adamgreen/Ferdinand16/photos/20160603-01.png

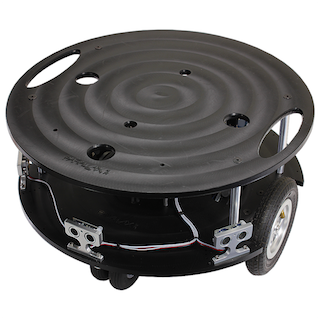
photos/20160603-01.png
