adamgreen/Ferdinand16/photos/20160730-01.jpg

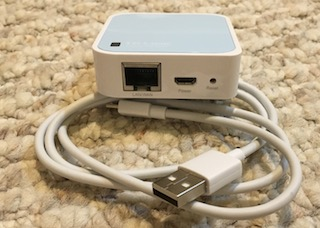
photos/20160730-01.jpg
