adamgreen/Ferdinand16/docs/28996-Arlo-Power-Dist-Brd-Schematic-Rev-B.pdf

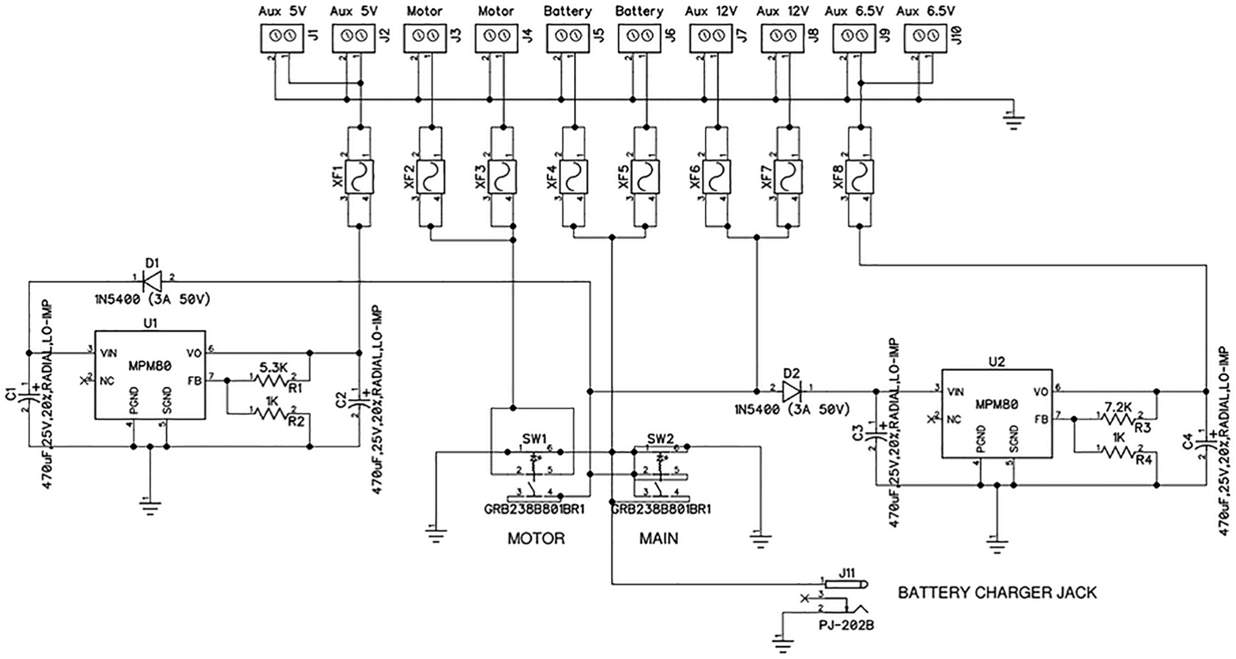
[picture p3: figure]
