adamgreen/Ferdinand16/docs/June2nd_gyro.numbers/preview-web.jpg

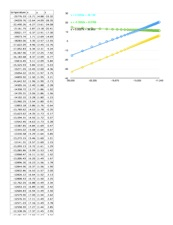
docs/June2nd_gyro.numbers/preview-web.jpg
