adamgreen/Ferdinand16/photos/20160603-02.jpg

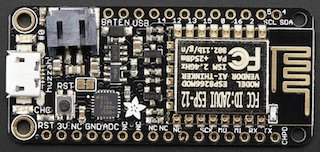
photos/20160603-02.jpg
