adamgreen/Ferdinand16/photos/20160603-03.png

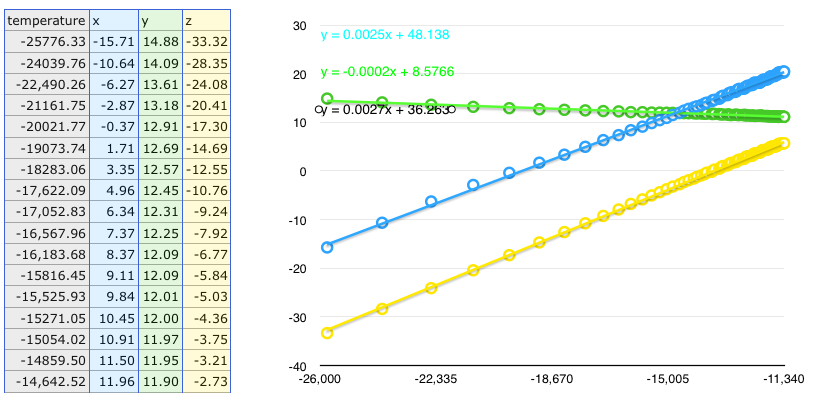
photos/20160603-03.png
