adamgreen/Ferdinand16/photos/20160603-04.jpg

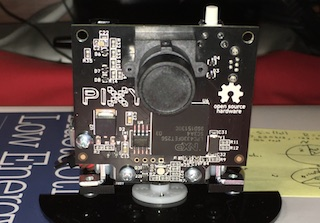
photos/20160603-04.jpg
