adamgreen/Ferdinand16/photos/20160603-05.jpg

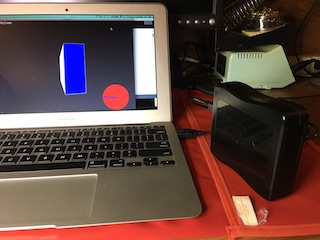
photos/20160603-05.jpg
