adamgreen/Ferdinand16/photos/20160603-06.jpg

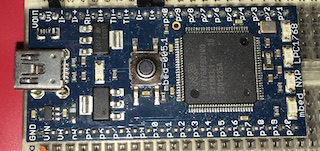
photos/20160603-06.jpg
