adamgreen/Ferdinand16/photos/20160603-07.png

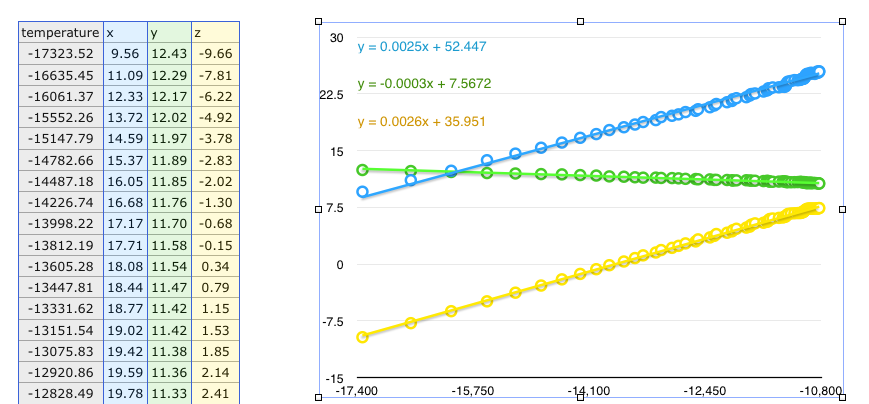
photos/20160603-07.png
