adamgreen/Ferdinand16/photos/20160606-01.jpg

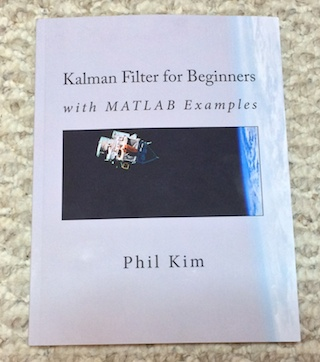
photos/20160606-01.jpg
