adamgreen/Ferdinand16/photos/20160606-02.jpg

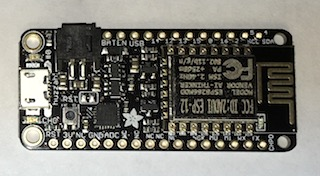
photos/20160606-02.jpg
