adamgreen/Ferdinand16/photos/20160607-01.jpg

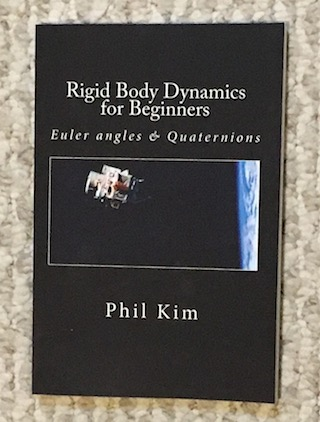
photos/20160607-01.jpg
