adamgreen/Ferdinand16/photos/20160609-01.jpg

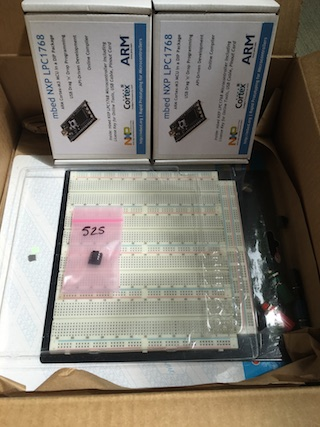
photos/20160609-01.jpg
