adamgreen/Ferdinand16/photos/20160612-01.jpg

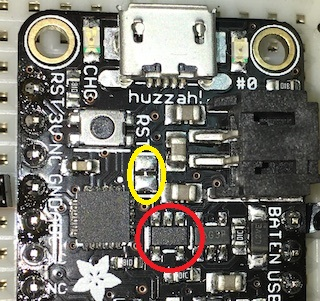
photos/20160612-01.jpg
