adamgreen/Ferdinand16/photos/20160612-02.jpg

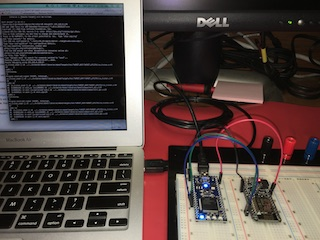
photos/20160612-02.jpg
