adamgreen/Ferdinand16/photos/20160619-01.jpg

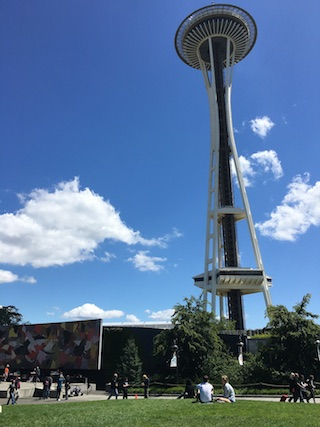
photos/20160619-01.jpg
