adamgreen/Ferdinand16/photos/20160619-02.jpg

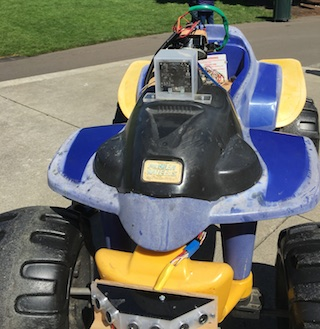
photos/20160619-02.jpg
