adamgreen/Ferdinand16/photos/20160619-03.jpg

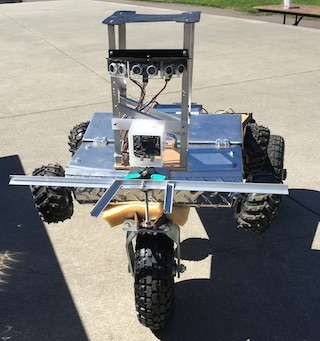
photos/20160619-03.jpg
