adamgreen/Ferdinand16/photos/20160619-04.jpg

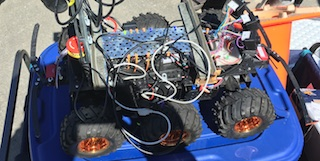
photos/20160619-04.jpg
