adamgreen/Ferdinand16/photos/20160619-05.jpg

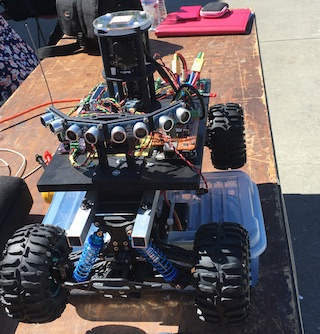
photos/20160619-05.jpg
