adamgreen/Ferdinand16/photos/20160620-01.jpg

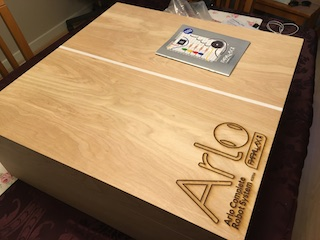
photos/20160620-01.jpg
