adamgreen/Ferdinand16/photos/20160620-02.jpg

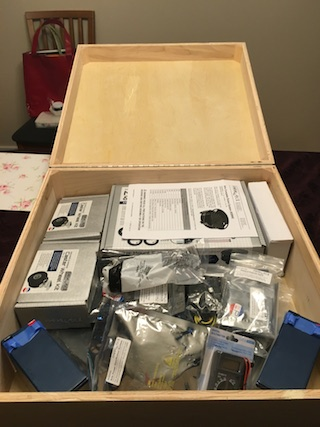
photos/20160620-02.jpg
