adamgreen/Ferdinand16/photos/20160620-03.jpg

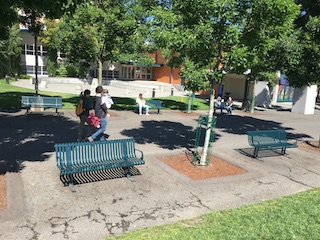
photos/20160620-03.jpg
