adamgreen/Ferdinand16/photos/20160624-01.jpg

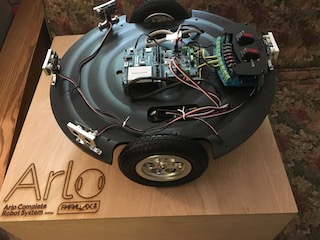
photos/20160624-01.jpg
