adamgreen/Ferdinand16/photos/20160720-01.jpg

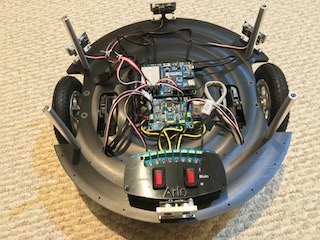
photos/20160720-01.jpg
