adamgreen/Ferdinand16/photos/20160720-02.jpg

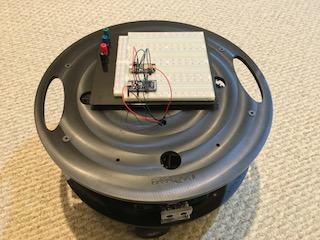
photos/20160720-02.jpg
