adamgreen/Ferdinand16/photos/20160722-01.jpg

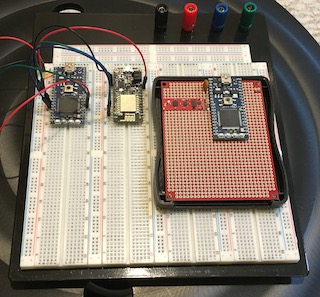
photos/20160722-01.jpg
