adamgreen/Ferdinand16/photos/20160722-02.jpg

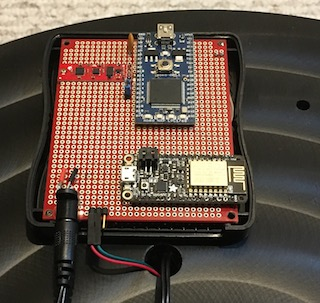
photos/20160722-02.jpg
