adamgreen/Ferdinand16/photos/20160723-01.png

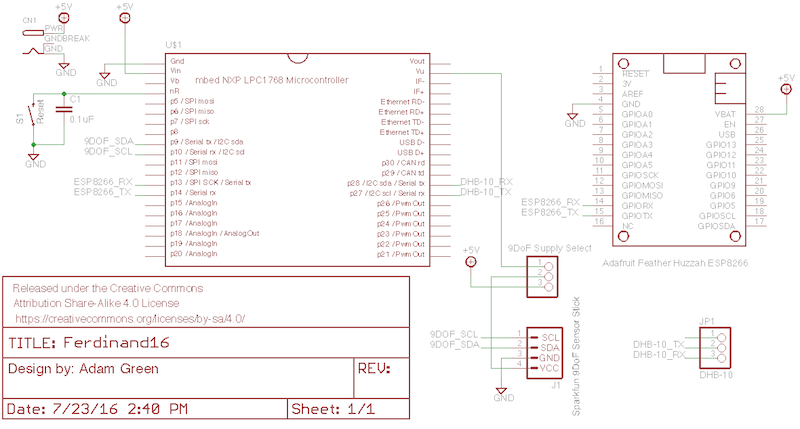
photos/20160723-01.png
