adamgreen/Ferdinand16/photos/20160723-02.png

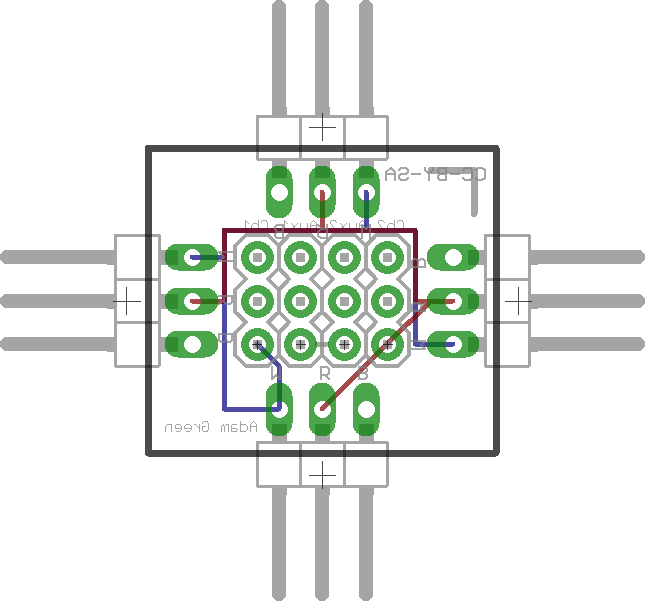
photos/20160723-02.png
