adamgreen/Ferdinand16/photos/20160728-01.jpg

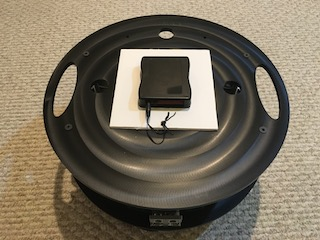
photos/20160728-01.jpg
