adamgreen/Ferdinand16/photos/20160929-01.jpg

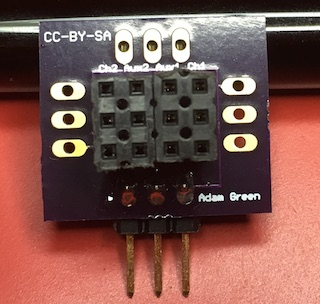
photos/20160929-01.jpg
