adamgreen/Ferdinand16/photos/20160929-02.jpg

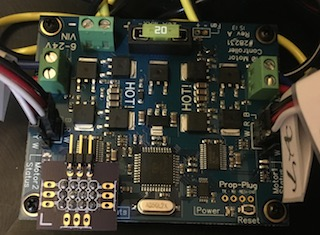
photos/20160929-02.jpg
