adamgreen/Ferdinand16/photos/20160929-03.jpg

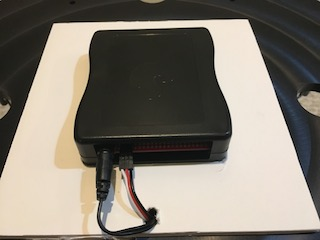
photos/20160929-03.jpg
