adamgreen/Ferdinand16/photos/20161004-01.jpg

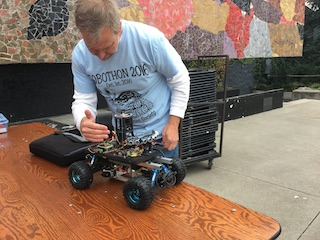
photos/20161004-01.jpg
