adamgreen/Ferdinand16/photos/20161004-04.gif

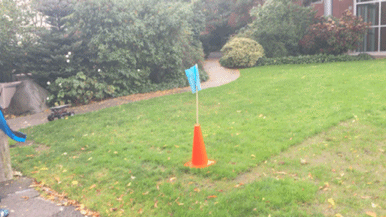
photos/20161004-04.gif
