adamgreen/Ferdinand16/docs/9DoF-Stick-v13.pdf

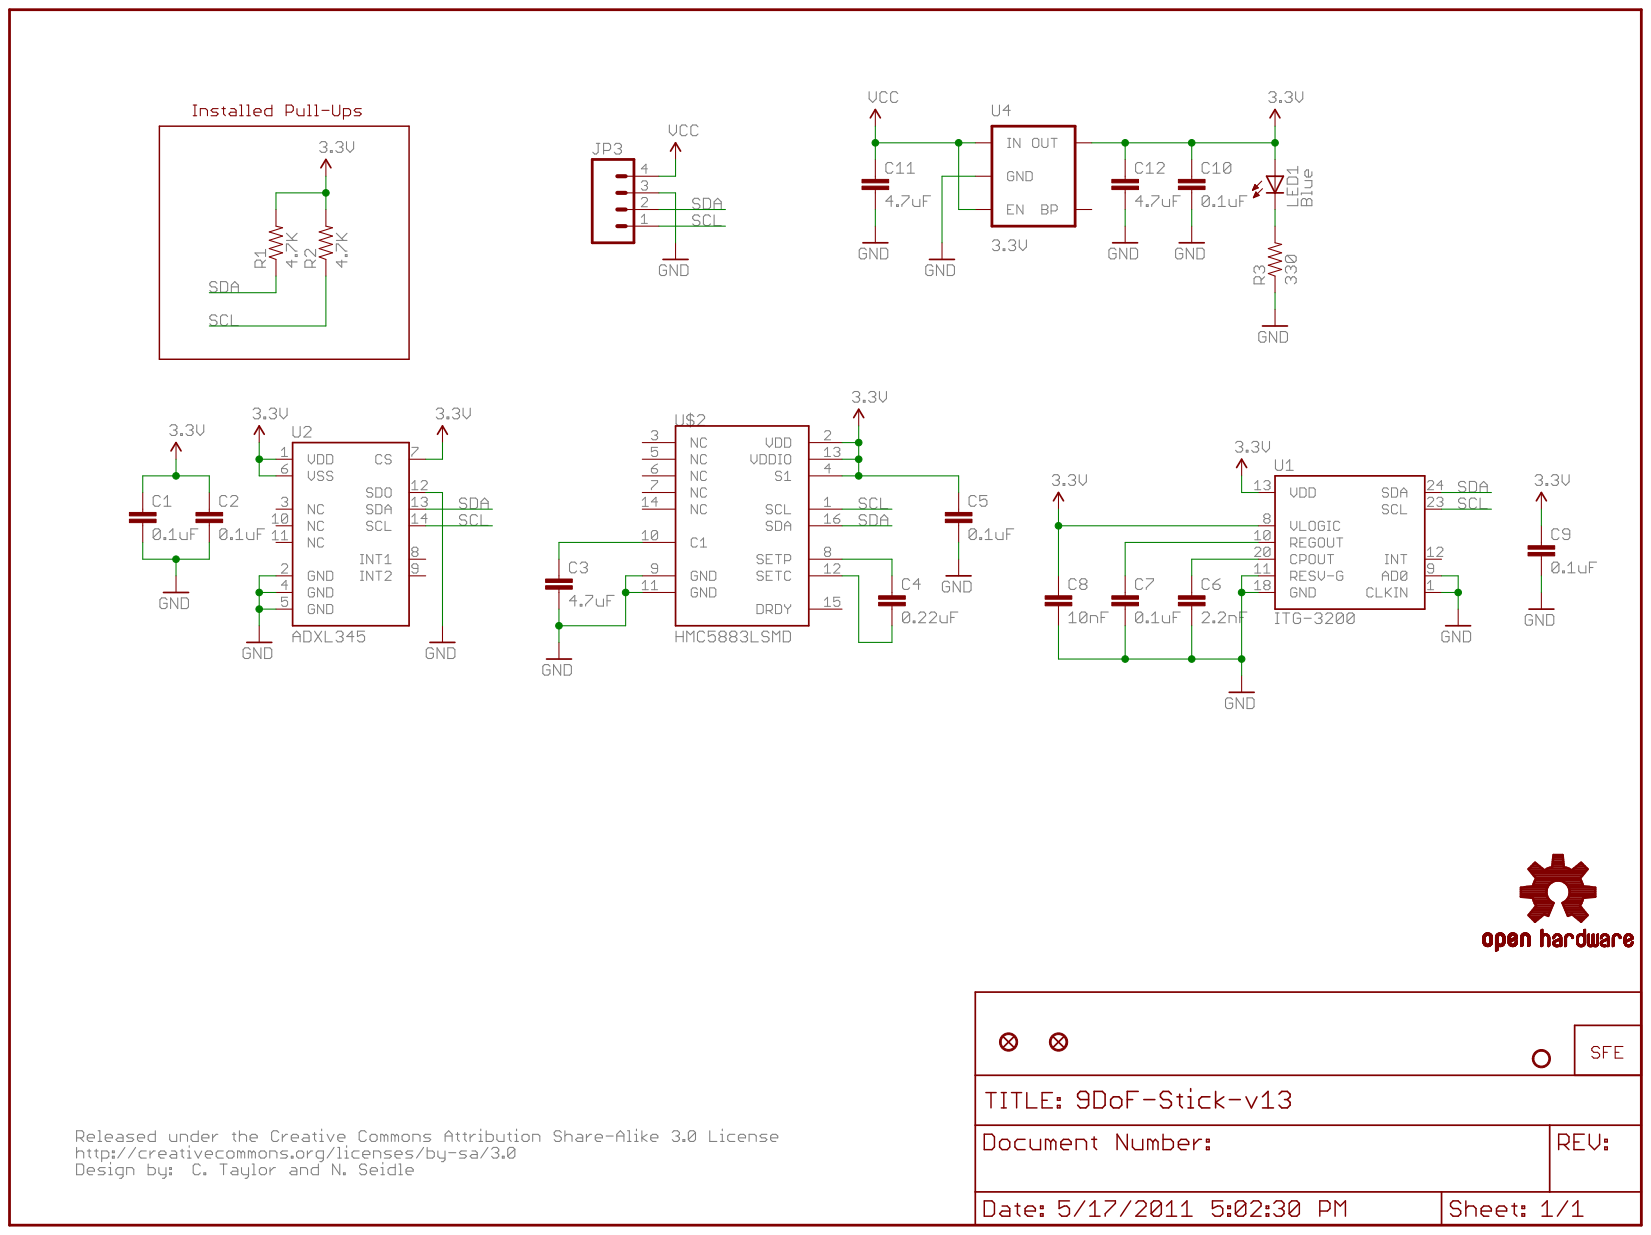
[picture p39: page 1]
