adamgreen/Ferdinand16/eagle/DHB-10_Serial_Converter.brd

## EAGLE design eagle/DHB-10_Serial_Converter.brd (2016-07-24)

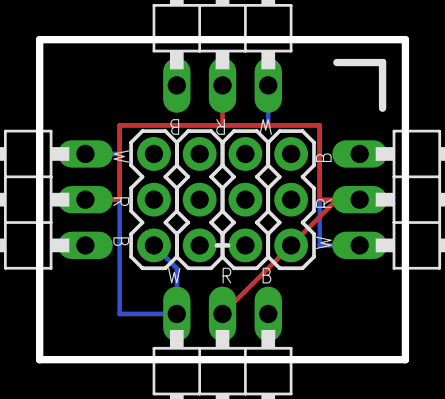
[picture p40: board DHB-10_Serial_Converter.brd from above]

Board: 2 copper layers, 20.3 x 17.8 mm, 8 parts (0 on the bottom side), 2 nets.

Parts:
E$1, E$6, E$7, E$8: 1X03/90
E$2, E$3, E$4, E$5: 1X03

Connections:
S$1: E$1.3, E$2.1, E$6.3, E$7.3, E$8.3
S$2: E$1.2, E$5.1, E$6.2, E$7.2, E$8.2
