adamgreen/Ferdinand16/firmware/robot/PID.h

/*  Copyright (C) 2015  Adam Green (https://github.com/adamgreen)

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
    This program is distributed in the hope that it will be useful,
    but WITHOUT ANY WARRANTY; without even the implied warranty of
    MERCHANTABILITY or FITNESS FOR A PARTICULAR PURPOSE.  See the
    GNU General Public License for more details.
*/
/* Class to abstract PID (proportional, integral, derivative) algorithm.
   It is inspired by Brett Beauregard's Arduino PID Library (https://github.com/br3ttb/Arduino-PID-Library/) and
   the PID e-book available on controlguru (http://www.controlguru.com).

   NOTE: compute() method has been modifed to expect angles in radians for the setpoint and process values such that
         the error needs to be constrained to fall between -PI and PI radians.
*/
#ifndef PID_H_
#define PID_H_

#include <assert.h>
#include <mbed.h>
#include <Sparkfun9DoFSensorStick.h>

class PID
{
public:
    PID(float Kc, float Ti, float Td, float controlOutputBias, float controlMin, float controlMax, float sampleTime)
    {
        m_sampleTime = sampleTime;
        setTuningParameters(Kc, Ti, Td);
        m_isAuto = false;
        m_controlOutputBias = controlOutputBias;
        m_controlMin = controlMin;
        m_controlMax = controlMax;
        m_controlOutput = controlOutputBias;
        m_setPoint = 0.0f;
        m_integral = 0.0f;
        m_processLast = 0.0f;
    }

    void updateSetPoint(float setPoint)
    {
        m_setPoint = setPoint;
    }

    float getSetPoint()
    {
        return m_setPoint;
    }

    float compute(float processCurrent)
    {
        if (m_isAuto)
        {
            float error = Sparkfun9DoFSensorStick::constrainAngle(m_setPoint - processCurrent);
            float processDelta = processCurrent - m_processLast;
            float integral = m_integral + m_Ki * error;
            float controlOutput;

            controlOutput = m_controlOutputBias + m_Kp * error + integral - m_Kd * processDelta;
            if (controlOutput < m_controlMin)
            {
                if (m_usesIntegral)
                    integral += (m_controlMin - controlOutput);
                controlOutput = m_controlMin;
            }
            else if (controlOutput > m_controlMax)
            {
                if (m_usesIntegral)
                    integral -= (controlOutput - m_controlMax);
                controlOutput = m_controlMax;
            }
            m_integral = integral;
            m_controlOutput = controlOutput;
        }

        m_processLast = processCurrent;
        return m_controlOutput;
    }

    float getControlOutput()
    {
        return m_controlOutput;
    }

    void setOutputManually(float controlOutput)
    {
        if (controlOutput < m_controlMin)
            controlOutput = m_controlMin;
        if (controlOutput > m_controlMax)
            controlOutput = m_controlMax;
        m_isAuto = false;
        m_controlOutput = controlOutput;
    }

    void enableAutomaticMode()
    {
        if (m_isAuto)
            return;
        m_controlOutputBias = m_controlOutput;
        m_setPoint = m_processLast;
        m_integral = 0.0f;
        m_isAuto = true;
    }

    void setTuningParameters(float Kc, float Ti, float Td)
    {
        assert( Ti >= 0.0f && Td >= 0.0f && sampleTime > 0.0f );
        m_Kp = Kc;
        m_Ki = (Ti == 0.0f) ? 0.0f : (Kc / Ti) * m_sampleTime;
        m_Kd = (Td == 0.0f) ? 0.0f : (Kc * Td) / m_sampleTime;
        m_usesIntegral = (Ti != 0.0f);
    }

protected:
    float   m_Kp;
    float   m_Ki;
    float   m_Kd;
    float   m_controlOutputBias;
    float   m_controlMin;
    float   m_controlMax;
    float   m_sampleTime;
    float   m_controlOutput;
    float   m_setPoint;
    float   m_integral;
    float   m_processLast;
    bool    m_isAuto;
    bool    m_usesIntegral;
};

#endif // PID_H_
