adamgreen/Ferdinand16/(commit log)

2016-06-04 Add photo
    This is the graph of the gyro zero bias versus temperature from 2014.
2016-06-04 Initial README notes
    * Ideas for Robo-Magellan 2016 robot.
    * Initial Pixy camera notes.
    * Re-calibration of roll axis rate gyro in IMU.
2016-06-04 Add gyro calibration spreadhsheet
    This spreadsheet was used to re-calculate the gyro zero bias vs.
    temperature calibration constants.
2016-06-04 Fork orientation sample from Ferdinand14
    Just copying the orientation sample over from the Ferdinand14 project.
    This orientation code uses a Kalman filter to calculate the 3D pose of
    the IMU. I plan to simplify the code to just obtain the compass heading
    and then port to run on the LPC1768 instead of on the PC.
2016-06-12 Add ESP8266 board photos
2016-06-14 Calculate yaw from quaternion directly
    Previously I was using a row from the rotation matrix (which was
    more expensively obtained from the quaternion) and I now just pull the
    yaw, pitch, and roll angles from the quaternion instead.
2016-06-17 Start porting orientation code to LPC1768
    This is the start of porting the orientation Processing sample to the
    LPC1768. It just starts with porting of the calibration code down to
    the LPC1768 whereas it could only return the raw sensor readings
    previously.
    * The calibration data is found in files/config.ini This file it built
    into a FlashFileSystem image which is then embedded into the firmware
    image as part of the makefile processing. NOTE: The makefile uses
    the fsbld and bin2h utilities to accomplish this and they only
    work on OS X.
    https://github.com/adamgreen/bb-8/tree/master/mriprog/bin2h-src
    https://github.com/adamgreen/fsbld
    * I pulled over the original LPC1768 firm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
2016-06-18 Calculate orientation quaternion from accelerometer/magnetometer
    This commit switches the firmware to returning an orientation
    quaternion based soley on the accelerometer and magnetometer data.
    Kalman filtering will be added later.
    The orientation Processing sample was modified to expect this
    4 x float quaternion instead of the 9 x float calibrated data I added
    in the previous commit. It compares this quaternion to the one
    calculated in the Processing code to verify that I didn't regress
    anything as I ported this math to the embedded device.
    [HeadingSensor.pde, main.cpp, orientation.pde]
2016-06-18 Swizzle accel/mag based on config.ini settings
    Previously the swizzling of the accelerometer and magnetometer axis was
    hardcoded. Now it is controlled by parameters in config.ini
    Additional changes include:
    * Added accelSwizzle and magSwizzle field to SensorCalibration struct
    to provide the new swizzle settings to the Sparkfun9DoFSensorStick
    class at construction time.
    * The Vector class now has a createFromSwizzledSource() static method
    which can take a source vector and swizzle its elements around to
    match the user provided settings from config.ini
    * Added a [] operator method ot Vector to expose x, y, and z values
    as [0], [1], and [2] respectively. This made the swizzling funct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
2016-06-21 Kalman filter ported to LPC1768
    This is the initial port of the Kalman filter from the Processing
    orientation.pde sample running on the PC to C++ code running on the
    LPC1768 microcontroller. The LPC1768 is currently idle for more than
    89% of the time when running this code. This is much better than I
    expected for all of that floating point math and gives me lots of
    headroom to execute my robot navigation code.
    NOTE: This ported code appears to work as expected when switching the
    orientation.pde sample into Embedded mode (by pressing the E
    key). The orientation sample does issue println()s though
    indicating that there are some differences in the PC and embedded
    calcul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
    [config.ini, main.cpp, orientation.pde]
2016-06-21 Add animated GIF of Kalman filter
2016-06-22 Kalman filter fixes
    * Make the Kalman filter reset a thread safe. Before it was possible
    for the code in main() which would trigger the Kalman filter
    to reset and the code which would prepend the "R," to the output
    would see different values of the g_resetRequested global that is
    set true in the serialRx ISR.
    * Sparkfun9DoFSensorStick::calibrate() gyroVariance & accelMagVariance
    variables shouldn't have been static or const. These qualifiers were
    left over from when the values were still hardcoded.
    * Orientation Processing sample shouldn't compare orientation
    quaternions sent back from LPC1768 until it has been placed in
    EMBEDDED mode where a synchronized filter will be trigg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
    [main.cpp, orientation.pde]
2016-06-23 PC and LPC1768 now agree on Kalman filter results
    I was normalizing the quaternion on the LPC1768 but not the PC. This is
    now fixed.
    I also fixed the code so that it only compares the embedded results
    after the reset has completed.
    Now get no differences detected when using a threshold of 1.0E-5.
    [orientation.pde]
2016-07-14 Commit some Parallax Arlo documentation
    * Documents for the DHB-10 Dual 10-Amp Motor Controller used on the
    Arlo robot platform for this Robo-Magellan bot. The LPC1768 will need
    to be interfaced to this motor controller in the near future.
    * The schematic for the power distribution board on the Arlo.
2016-07-14 Update compass/heading rendering
    I moved the code to calculate the compass heading from orientation.pde
    to HeadingSensor.pde This code was then updated to:
    * Return a heading angle of 0 when the robot is facing north.
    * Return a heading angle of PI/2 when the robot is facing east and
    an angle of -PI/2 when facing west.
    * Add configuration options to calibrate for the magnetic declination
    error at the location where the robot is being run and to account
    for how the IMU is mounted on the robot. The current settings are
    for Redmond, WA and with the IMU project box mounted such that the
    USB cable connects towards the rear of the robot.
    * The compass needle in the orientation.pde sampl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
    [HeadingSensor.pde, orientation.pde]
2016-07-15 Port heading calculation to LPC1768
    The compass heading calculation code is now running on the LPC1768 and
    has been appended to the end of the list of measurements returned to
    the PC one hundred times/second.
    I also added code to the orientation Processing sample to compare the
    heading calculated on the PC to the value calculated by the LPC1768 and
    an error is displayed to the console if they differ.
    [HeadingSensor.pde, config.ini, main.cpp, orientation.pde]
2016-07-15 Start IMU firmware up in mode compatible with old samples
    The old Ferdinand14 samples like the ones I have for performing sensor
    calibration only expect the raw sensor readings. I have modified the
    firmware running on the LPC1768 to startup in a mode which only returns
    these raw sensor measurements and only starts returning the Kalman
    calculated values after a Kalman reset command has been sent from the
    PC.
    [HeadingSensor.pde, main.cpp]
2016-07-19 Move firmware & Processing code into sub-folders
    To support more than one Processing sample and firmware image for this
    project, there are now processing/ and firmware/ parent folders. The
    multiple Processing samples can be placed under processing/ and the
    different firmware images can be placed under firmware/.
    I also added the mriprog utility for OSX under the osx/ folder. This
    utility can be used to remotely program a LPC1768 device which is
    already running firmware utilizing the MRI debug monitor.
2016-07-19 Build DmaSerial as a library
    I want to share the DmaSerial functionality between the basic heading
    firmware that I have been working on so far and the other firmware
    variants that I plan to create in the future. To facilitate this, I
    have moved the DMA code out into its own libs/DmaSerial directory. I
    also replaced DMA.h with GPDMA.h/c from my NeoPixelTree project where
    I added GPDMA channel allocation functionality. This will allow me to
    have more than a single DmaSerial object instantiated (one for logging
    and the other for the Parallax DHB-10 Dual Motor Controller.)
2016-07-20 Add simple drive sample
    This sample instructs the Arlo platform to drive ahead at a speed of
    100 encoder ticks per second and verifies that the overall distance
    travelled (in encoder ticks) has increased as expected. This test is
    run for 2 seconds and then the robot is stopped.
    The bulk of the functionality is provided by the newly added
    libs/MotorController library which knows how to talk to the Parallax
    DHB-10 Dual Motor Controller on the Arlo.
    I have also added the bash scripts that I use for remote debug/
    programming of the LPC1768 on the robot.
2016-07-20 Add photos of completed Arlo build
    With Propeller board as the brains and another with the mbed LPC1768 as
    the brains.
2016-07-23 Move orientation sensor code into libraries
    I have moved the Sparkfun9DoFSensorStick code out into its own library
    so that it can be shared by the current Heading firmware and the new
    firmware for the robot itself. I also moved ConfigFile and
    FlashFileSystem out into their own libraries as well.
2016-07-23 Add IMU sensor documentation
2016-07-23 Initial Ferdinand16 schematic
    I created a schematic in Eagle CAD to provide an overview of what
    electronics I am currently using for the brains of my Ferdinand16
    project.
    [Ferdinand16.sch]
2016-07-24 Add DHB-10 serial converter board layout
    I used Eagle CAD to create a PCB layout for a board which attaches to
    the I/O pins on the Parallax DHB-10 Dual Motor Controller and allows
    the user to utilize a 3-wire servo cable for full-duplex serial
    communication. Once mounted on the 3x4 DHB-10 I/O header, the user
    can connect their 3-wire servo cable to one of the 90 degree 3-pin
    headers along the perimeter of the board.
    Pin Mappings:
    Pin 1 (W marking) - White Servo Wire - DHB-10 Rx
    Pin 2 (R marking) - Red Servo Sire - DBH-10 Tx
    Pin 3 (B marking) - Black Servo Wire - Unconnected
    [DHB-10_Serial_Converter.brd]
2016-07-27 Re-calibrate heading sensor after mounting on robot
    The magnetometer calibration data had to be updated to account for hard
    iron on the robot. I also adjusted the compass.mountingCorrection to
    account for the fact that I mounted the project box 180 degrees from
    the original orientation. The USB connector now points towards the
    front of the robot and not the back.
2016-07-28 Update mriprog utility
    I modified mriprog so that the second stage bootloader finds the MRI
    UART by searching for the UART ISR with the highest priority.
    Previously it expected it to have the highest priority (level 0) but I
    have an upcoming commit which sets it to one level below this.
2016-07-28 Add DebugSerial library/class
    This class can be used to extend the functionality of the MRI debug
    monitor. In particular, it allows for the sending of debug output to
    GDB in an async fashion without blocking the CPU. Without this class
    output is sent to the GDB console using printf() which ends up
    halting into the MRI debug monitor to start a dialog with GDB and it
    remains halted until all of the text has been sent to GDB. When a
    DebugSerial object is constructed, it will find the UART used by MRI
    and hijack its ISR. The outputStringToGdb() method can be called to
    utilize DMA to asynchronously send the O (output) packet to GDB. The
    ISR shim will detect GDB sending back acks for these O packe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
2016-07-28 Initial Robo-Magellan robot firmware
    This code doesn't really do much at this point. It does pull in the
    Sparkfun9DoFSensorStick and MotorController classes that will be needed
    by the robot for initial navigation tests. It also has the start of the
    debugging framework that I plan to use.
    It takes advantage of the DebugSerial class for sending messages to the
    GDB console in an asynchronous fashion to minimize the impact on
    performance.
    [main.cpp]
2016-07-28 Add photo of mounted project box
2016-07-29 Rotate robot inplace for PID modelling
    The robot firmware now runs in a mode where it oscillates back and
    forth 90 degrees around its original orientation. While doing this
    oscillation it logs the time, current heading angle from the
    orientation sensor, and the control output being sent to the motors.
    Issuing the "set logging on" command to GDB before starting this test
    will cause the logged data to be recorded in gdb.txt. I then edit
    this logged output to only include the comma separated data found
    between these two lines:
    Starting oscillations between ##.## and ##.##...
    ...
    PID Calibration completed.
    This results in many lines of data like the following:
    19,7.536273,10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
    [pid.csv]
2016-07-30 Robot can now maintain compass heading
    This commit contains test code which:
    * First waits 10 seconds for the Kalman filter to settle.
    * At the end of 10 seconds, the current compass heading is used as the
    setpoint for the PID algorithm.
    * On every second iteration of the main run loop, the PID calculation
    is run to determine how much the robot's heading should be altered
    given the error there is between the current robot heading and the
    desired setpoint.
    * The motor controller is then sent speeds for the left and right
    wheels based on a base rate of 50 encoder ticks/second and the
    correction obtained from the PID algorithm.
    Other notes:
    * The code in PID::compute() constrains t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
    [PID.h, main.cpp]
2016-09-30 Photos of serial converter PCB
