adamgreen/Ferdinand16/(notices)

Notices in the files:
processing/orientation/Heading.pde:
modify it under the terms of the GNU General Public License
eagle/DHB-10_Serial_Converter.brd:
CC-BY-SA
parts and their libraries:
SparkFun-Capacitors: Licensing: Creative Commons ShareAlike 4.0 International - https://creativecommons.org/licenses/by-sa/4.0
adam_custom: Creative Commons Attribution-Share Alike 4.0 License Document Field
